icepaule/Ice-Traffic-Data/README.md

# Ice-Traffic-Data

Mobiler Empfang von **C-ITS / ITS-G5 (802.11p)** Verkehrsdaten im Auto – Ampeldaten (SPATEM/MAPEM), Fahrzeugmeldungen (CAM) und Gefahrenmeldungen (DENM) – mit zwei günstigen ESP32-Boards und Anzeige über das iPhone.

> **Status:** Firmware (C5 + C3) und lokaler Decoder bauen/laufen; Decoder mit synthetischen Daten getestet. Hardware (DigiKey) ist bestellt, **echte Funkdaten stehen noch aus**. Auch als Webseite: <https://icepaule.github.io/Ice-Traffic-Data/>. Offene Punkte stehen in [docs/07-offene-punkte.md](docs/07-offene-punkte.md).

## Idee in einem Bild

Diagramm readme-0

<details><summary>Mermaid-Quelltext</summary>

```mermaid
flowchart LR
    RSU["Ampel / RSU<br/>Fahrzeuge / Baustellenwarner"] -- "ITS-G5 5,9 GHz" --> C5["ESP32-C5<br/>Sniffer"]
    C5 -- "UART 921600, ITS6-Format" --> C3["ESP32-C3<br/>WLAN/MQTT-Bruecke"]
    C3 -- "WLAN 2,4 GHz" --> HS["iPhone<br/>Hotspot"]
    HS -- "LTE/5G, MQTT/TLS" --> SRV["Heimserver<br/>Decoder + Dashboard"]
    SRV --> SAF["Safari auf dem iPhone"]
```

</details>

## So sieht das Dashboard aus (Demo-Daten)
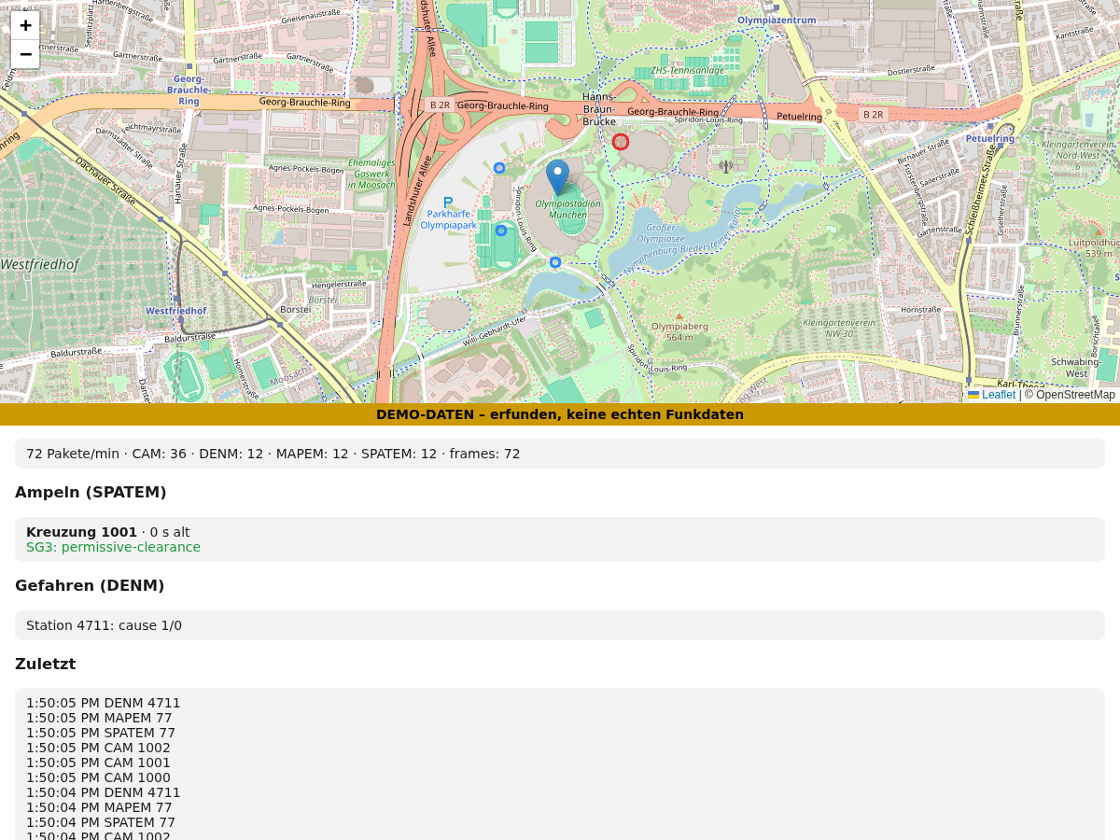
[picture p1: docs/screenshots/dashboard-demo.png]
Dashboard mit erfundenen Demo-Daten


## Anleitung (Schritt für Schritt)

| Schritt | Thema |
|---|---|
| 0 | [Architektur, Setup und Datenfluss (Mermaid)](docs/00-architektur.md) |
| 1 | [Grundlagen: Verkehrsdaten-Techniken & Nachrichtentypen](docs/01-grundlagen.md) |
| 2 | [Hardware & Einkaufsliste](docs/02-hardware.md) |
| 3 | [Verdrahtung](docs/03-verdrahtung.md) |
| 4 | [Firmware bauen & flashen](docs/04-firmware.md) |
| 5 | [iPhone-Hotspot & MQTT](docs/05-iphone-mqtt.md) |
| 6 | [Testfahrt München / Ottobrunn](docs/06-testfahrt.md) |
| 7 | [Offene Punkte & Ausbau](docs/07-offene-punkte.md) |
| 8 | [Anbindung an den Heimserver (DDNS, TLS-MQTT)](docs/08-heimserver.md) |
| 9 | [Lokaler Decoder & Dashboard](docs/09-decoder.md) |
| 10 | [Analyse: LoRa(WAN) vom Auto nach Hause](docs/10-lorawan.md) |
| 11 | [Antennen](docs/11-antennen.md) |
| 12 | [Stückliste & Bestellung DigiKey](docs/12-bestellung.md) |
| 13 | [Dashboard öffentlich (its.mpauli.de, Vorlage THW-Barbeleg)](docs/13-dashboard-veroeffentlichen.md) |
| 14 | [Inbetriebnahme & Vorbereitung ohne Hardware](docs/14-inbetriebnahme.md) |
| 15 | [TEMPUS: Recherche & Unterstützungsangebot (Mail-Entwurf)](docs/15-tempus.md) |
| 16 | [ToDo nach Liefereingang & Zugänge](docs/16-todo-nach-lieferung.md) |
| 17 | [Umsetzungsplan (Phasen 0–9, mit Teilen)](docs/17-umsetzungsplan.md) |
| 18 | [Stand Schreibtischtest, Statusseite & Mitschnitt](docs/18-schreibtischtest-und-mitschnitt.md) |
| 19 | [Gehäuse (3D-Druck, SolidWorks-STEP)](docs/19-gehaeuse.md) |
| 20 | [Auswertung der ersten Testfahrt (echte CAM/DENM, Beifang)](docs/20-auswertung-testfahrt-1.md) |
| 21 | [Testfahrt 1: Empfangs-Timeline, Karte, Verbesserungen](docs/21-testfahrt-1-timeline-karte-verbesserungen.md) |
| 22 | [Plan und Umsetzung Verbesserungen V1–V9](docs/22-plan-verbesserungen.md) |
| 23 | [TEMPUS-Nachfolge, heutige Einsätze, Erweiterungen](docs/23-tempus-nachfolge-und-erweiterungen.md) |
| 24 | [Messfahrt 2: Vorbereitung und Checkliste](docs/24-messfahrt-2-vorbereitung.md) |

## Quellen

- Firmware: <https://github.com/bertrik/its-g5-receiver> (Ordner `esp32-c5-sniffer/`, `esp32-c3-bridge/`)
- Projektbeschreibung des Autors: <https://revspace.nl/Its-g5>
- OpenTrafficMap Wiki: <https://wiki.opentrafficmap.org>
- Alternative (Android): V2X2MAP, CITS-to-go
