icepaule/Ice-Traffic-Data/docs/19-gehaeuse.md

# 19 – Gehäuse (3D-Druck, Entwurf v0.3)

Ein Gehäuse für **alle** Teile: Traffik-Sniffer (C5), Trafik-CPU (C3), GPS-LoRa (XIAO + Wio-SX1262), Grove-GPS und das Prepboard. Konstruiert **parametrisch** mit [CadQuery](https://github.com/CadQuery/cadquery) (`hardware/case/ice_traffic_case.py`). Die STEP-Dateien lassen sich in **SolidWorks** öffnen (Datei → Öffnen → STEP), die STL-Dateien gehen direkt in den Slicer.

> **Status: Entwurf v0.2.** Nur die Länge des Traffik-Sniffers (53,5 mm) ist gemessen. Die übrigen Maße stammen aus Herstellerunterlagen (Espressif-Zeichnung, Seeed-Wiki) oder sind geschätzt (siehe „Maße der Boards"). **Vor dem Druck prüfen** und im Skript oben anpassen.

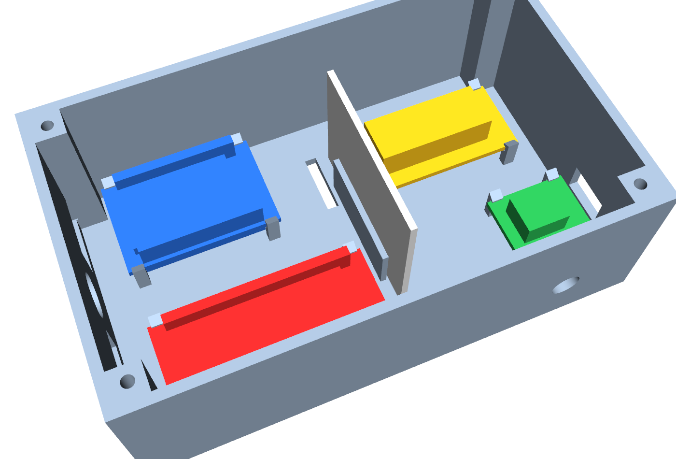
[picture p2: docs/screenshots/gehaeuse-bestueckt.png]
Gehäuse bestückt


*Unterteil mit Platzhalter-Boards: rot = Traffik-Sniffer, blau = Trafik-CPU, grün = GPS-LoRa, gelb = Grove-GPS, grau = Prepboard (hochkant). Die Platzhalter sind nur zur Kollisionsprüfung da, sie sind nicht Teil des Drucks.*

## Änderung v0.3 (09.11.2026, nach dem ersten Einbau)

Beim Einbau passte v0.2 nicht: Stege (Schraubdome) blockierten die Boards, und das hochkant stehende Prepboard in der Mitte stand 4 mm hinter dem Ende von C5 und C3 und damit vor deren WLAN-Antennen. Änderungen:

- **Prepboard-Schlitz entfällt** (Rippen in Unterteil und Deckel); das Prepboard wird innen an den Deckel geklebt. Die Mitte ist frei.
- **C5 und C3 nach innen:** 8 mm statt 2 mm Abstand zur Vorder- bzw. Rückwand (frei von den 7-mm-Domen) und 16 mm statt 8 mm zur linken Wand. Die USB-Schlitze folgen den Boards; die Stecker laufen durch den Wandschlitz in den leeren Innenraum.
- **Strombuchse** (Ø 11 mm) wandert an die **rechte** Stirnwand (Y = 34,4 mm), weil zwischen C5 und C3 nur noch etwa 3 mm bleiben. Das GPS rückt dafür 2 mm nach hinten (Y = 42 mm).
- **Gemessene Gesamtlängen** (inkl. USB und WLAN-Antenne): **C5 60 mm, C3 45 mm**; die Platten sind 53,5 bzw. 38,9 mm lang, der Rest ist Überstand (vermutlich Antenne am Ende gegenüber USB, die Aufteilung ist nicht gemessen). Das Modell führt den Überstand als Platzhalter am +X-Ende. Damit endet der C5 bei X = 76 mm, der C3 bei X = 61 mm.
- **GPS** rückt dafür auf X = 76 mm. **Freiraum hinter den Antennen:** C3 bis GPS 15 mm, C5 bis XIAO 20 mm (Faustwerte, keine Herstellerwerte). Kollisionsrechnung gegen Wände, Dome, Clips, Boards und Strombuchse: keine Kollision.
- Neue **Passprobe `IceTraffic_Passprobe_C5_Ecke`** (42 × 46 × 16 mm): Eckdom, Wände, USB-Schlitz und Clips des C5 in der neuen Lage. Mit der **echten Platine** prüfen, bevor das ganze Gehäuse gedruckt wird.

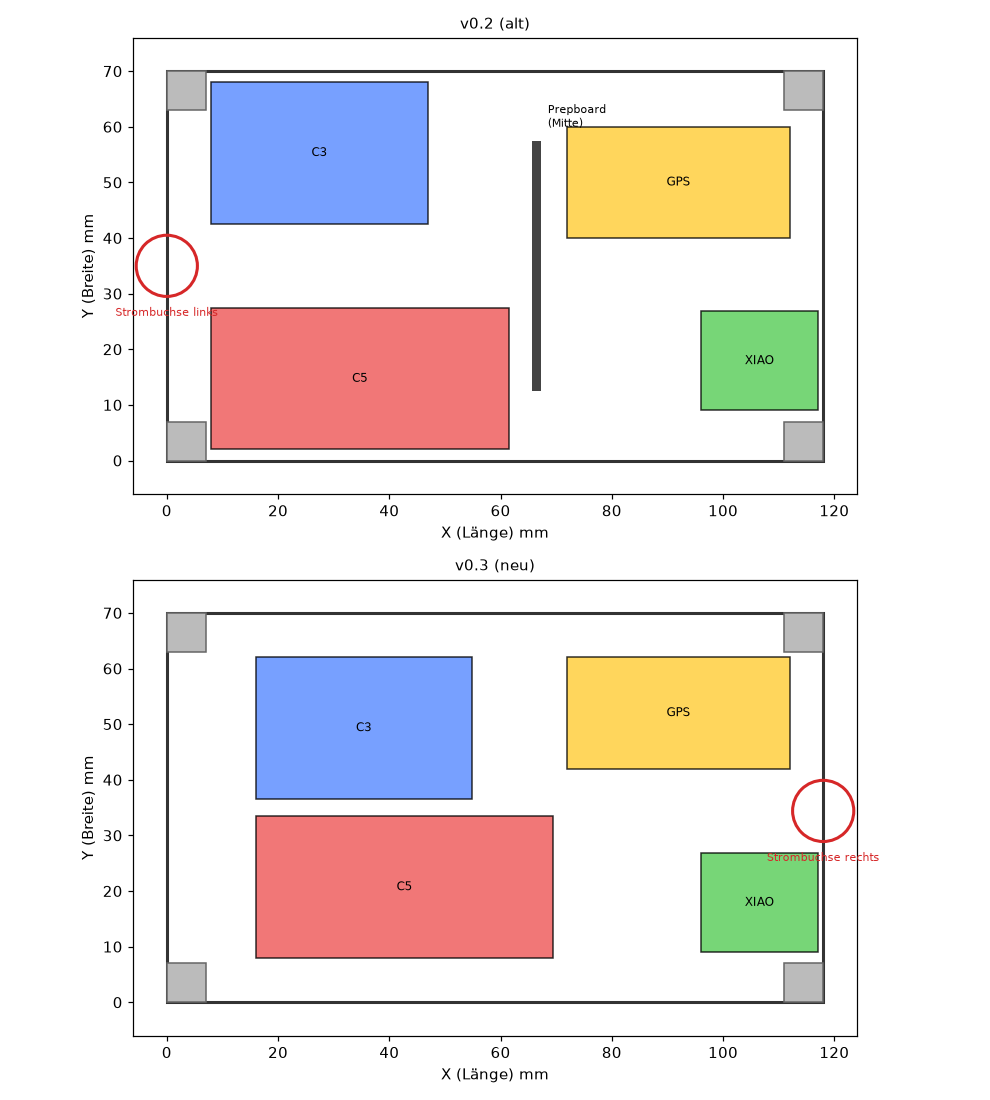
[picture p3: docs/screenshots/gehaeuse-v03-draufsicht.png]
Draufsicht alt und neu


**Grenze der Prüfung:** Die Kollisionsrechnung im CAD-Modell findet für v0.2 und v0.3 keine Kollision, weil das Modell nur die angenommenen Boardmaße kennt. Sie reproduziert also das, was beim Einbau passiert ist, nicht. Die echten Maße von C5 und C3 (Breite mit Stiftleisten, Lage der Antenne) sind weiter nicht gemessen; die Passprobe mit der echten Platine ist die eigentliche Prüfung. Die älteren Bilder weiter unten zeigen noch v0.2.

## Maße und Bohrungen

| Merkmal | Wert |
|---|---|
| Außenmaß (Unterteil) | 122,8 × 74,8 × 40,4 mm (Innenraum 118 × 70 × 38 mm) |
| Wand / Boden | 2,4 mm |
| **Antenne** | **Ø 7 mm**, Frontwand, Höhe 12 mm, nahe dem GPS-LoRa |
| **Stromanschluss** | **Ø 11 mm**, **rechte** Stirnwand (v0.3), Y = 34,4 mm zwischen XIAO und GPS, Höhe 16 mm |
| USB-Zugang | ein Schlitz 24 × 10 mm für C5 (2 × USB-C) und 16 × 10 mm für C3 (Micro-USB), linke Wand, ein Schlitz 12 × 8 mm für das GPS-LoRa (rechte Wand; das GPS-LoRa sitzt direkt an dieser Wand) – Flashen ohne Öffnen |
| Deckel | 4 × M3 in Eckdomen (Kernloch 2,8 mm für selbstschneidende Schrauben), Senkung für Linsenkopf, 8 Lüftungsschlitze, Stützlippe |
| Boden | je 4 Schlitze (3 × 16 mm) für Kabelbinder oder Klett zur Befestigung im Auto |

## Aufnahme der Platinen (Clips)

Jede Platine liegt auf vier Auflagen und wird von vier **Schnappclips** in den Ecken gehalten: Auflage 0,8 mm unter der Platine, Haken 0,7 mm über der Platine (oben angeschrägt). Platine **schräg einsetzen** und eindrücken, der dünne Steg (1,2 mm) gibt nach. Zwischen Boden und Platinenunterseite bleiben **5 mm** für die Stiftleisten. Die Clips sitzen in den Ecken, damit sie die Stiftleisten (ab etwa 1 mm Randabstand) nicht berühren.

Das **Prepboard (35 × 45 mm)** hat seit v0.3 keinen Schlitz mehr, es wird innen an den Deckel geklebt (v0.2: hochkant in der Mitte).

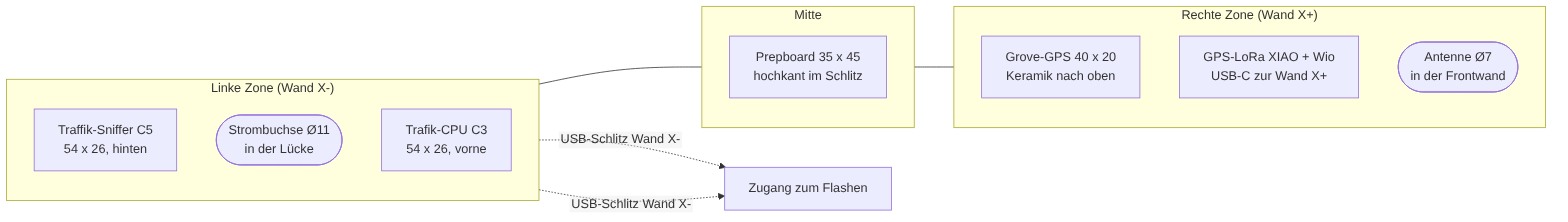
[picture p4: docs/diagrams/19-gehaeuse-layout-0.png]
Anordnung


<details><summary>Mermaid-Quelltext</summary>

```mermaid
flowchart LR
    subgraph LINKS["Linke Zone (Wand X-)"]
        direction TB
        C5["Traffik-Sniffer C5<br/>54 x 26, hinten"]
        PWR(["Strombuchse Ø11<br/>in der Lücke"])
        C3["Trafik-CPU C3<br/>54 x 26, vorne"]
    end
    subgraph MITTE["Mitte"]
        PREP["Prepboard 35 x 45<br/>hochkant im Schlitz"]
    end
    subgraph RECHTS["Rechte Zone (Wand X+)"]
        direction TB
        GPS["Grove-GPS 40 x 20<br/>Keramik nach oben"]
        XIAO["GPS-LoRa XIAO + Wio<br/>USB-C zur Wand X+"]
        ANT(["Antenne Ø7<br/>in der Frontwand"])
    end
    LINKS --- MITTE --- RECHTS
    C5 -. "USB-Schlitz Wand X-" .-> W1["Zugang zum Flashen"]
    C3 -. "USB-Schlitz Wand X-" .-> W1
```

</details>

## Ansichten

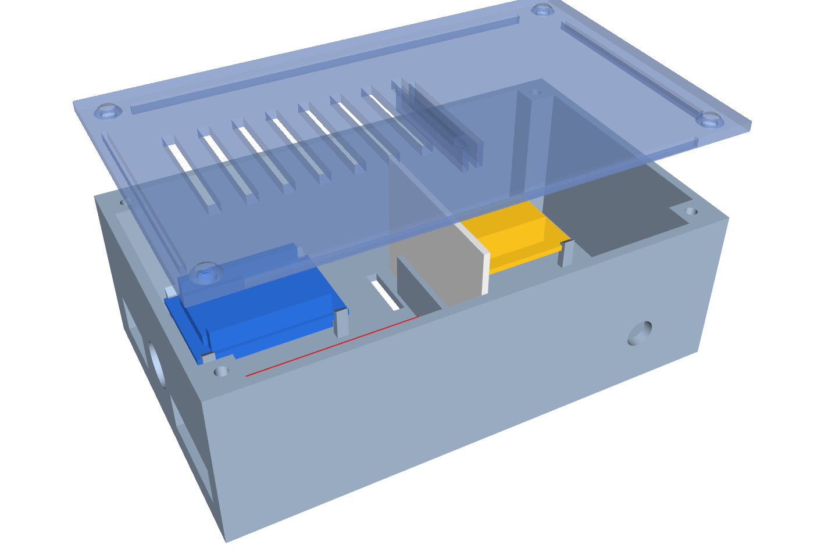
[picture p5: docs/screenshots/gehaeuse-explosion.png]
Explosion


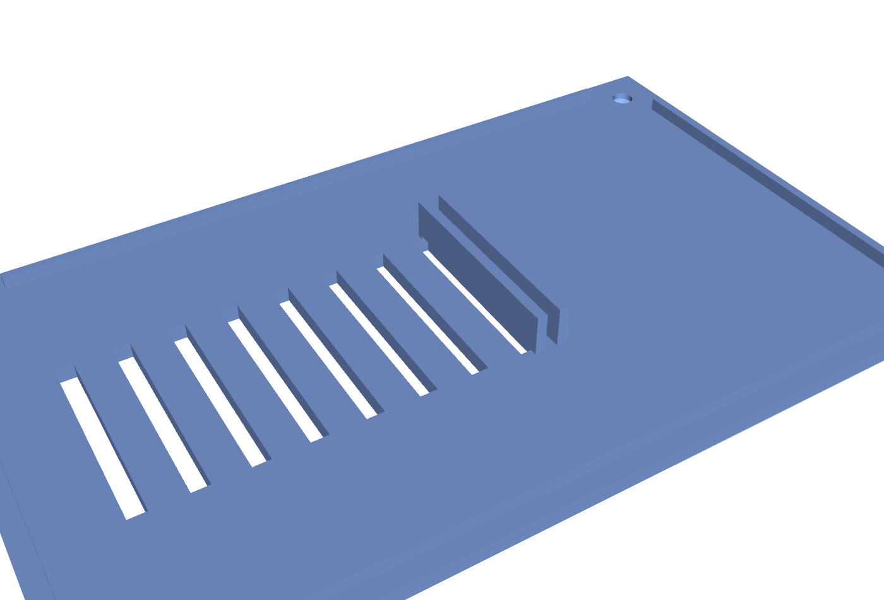
[picture p6: docs/screenshots/gehaeuse-deckel.png]
Deckel


## Dateien

| Datei | Zweck |
|---|---|
| `hardware/case/ice_traffic_case.py` | parametrisches Skript (Maße oben im Kopf) |
| `hardware/case/cad/IceTraffic_Gehaeuse_Unterteil.step` / `.stl` | Unterteil |
| `hardware/case/cad/IceTraffic_Gehaeuse_Deckel.step` / `.stl` | Deckel, **in Druckrichtung** (Platte unten) |
| `hardware/case/cad/IceTraffic_Montage_mit_Boards.step` | Zusammenbau mit Platzhalter-Boards, Deckel in Einbaulage (für SolidWorks-Passprüfung) |

Neu erzeugen: `pip install cadquery && python3 hardware/case/ice_traffic_case.py hardware/case/cad`

## Druck auf dem Anycubic Kobra S1

| Einstellung | Empfehlung |
|---|---|
| Werkstoff | **PETG** oder **ASA**, kein PLA (im Auto über 55 °C weich, Sonne hinter der Scheibe reicht) |
| Schicht / Wand | 0,2 mm, 3 Wände, 25 % Füllung |
| Ausrichtung | Unterteil mit der Öffnung nach oben, Deckel mit der Platte unten (so liegt die STL) |
| Stützen | keine nötig (Antennen- und USB-Öffnungen werden überbrückt, Haken sind 45°-Schrägen); bei Problemen Stützen nur für die Öffnungen in den Wänden |
| Passprobe | zuerst nur den Bereich mit einem Clip drucken (ca. 20 min) und eine Platine einsetzen |

Bauraum: das Unterteil (123 × 79 mm) passt bequem auf das Druckbett.

## Passprobe (vor dem großen Druck)

`IceTraffic_Passprobe.stl` / `.step` (64 × 54 × 16 mm, rund 20 Minuten Druck) enthält die kritischen Stellen auf einer Platte:
- das **Ende des Traffik-Sniffers** mit zwei Clips (Platine nur auflegen und eindrücken),
- den **kompletten GPS-LoRa-Stapel** mit vier Clips,
- den **Prepboard-Schlitz** (Platine hochkant einschieben, soll mit leichtem Klemmen halten),
- eine Rückwand mit der **Antennenbohrung Ø 7** und der **Strombohrung Ø 11** (Buchse und SMA-Stecker probehalber einsetzen).

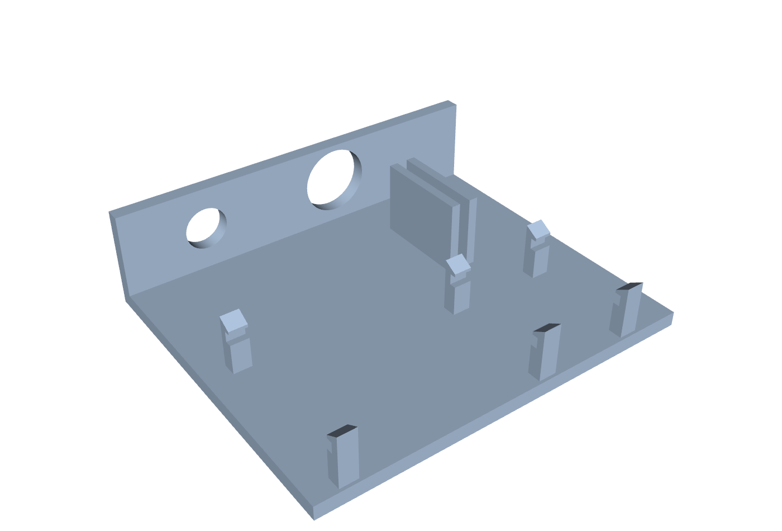
[picture p7: docs/screenshots/gehaeuse-passprobe.png]
Passprobe


Prüfen: Rastet die Platine hörbar ein, ohne dass ein Clip bricht? Sitzt sie ohne Spiel? Passt die Buchse in Ø 11? Wenn ein Clip zu stramm oder zu locker ist, `TOL`, `LEDGE` und `HOOK` im Skript anpassen.

## Maße der Boards (Stand v0.2)

| Board | Maß im Modell | Quelle |
|---|---|---|
| Traffik-Sniffer (ESP32-C5-DevKitC-1) | **53,5 × 25,4 mm** Platte, **60 mm Gesamtlänge** inkl. USB und WLAN | Platte: Länge gemessen, Breite Espressif (25,4); Gesamtlänge gemessen (09.11.2026) |
| Trafik-CPU (ESP32-C3-DevKitM-1) | **38,9 × 25,4 mm** Platte, **45 mm Gesamtlänge** inkl. USB und WLAN | [Espressif-Maßzeichnung (DXF)](https://dl.espressif.com/dl/schematics/DIMENSION_ESP32-C3-DEVKITM-1_V1_20200915AA.dxf): 25,40 × 38,91; Stiftreihen etwa 22,86 mm auseinander, 1,27 mm vom Rand |
| GPS-LoRa (XIAO ESP32S3 auf Wio-SX1262, B2B-Stapel) | **21 × 17,8 mm**, Höhe geschätzt (ca. 6 mm Bauteile) | [Seeed-Wiki](https://wiki.seeedstudio.com/wio_sx1262_with_xiao_esp32s3_kit/) (21 × 17,8); Stapelhöhe und Lage von USB-C und U.FL **nicht angegeben** |
| Grove-GPS Air530 | **40 × 20 mm**, Höhe bis 13 mm | Händlerangaben, kein Herstellermaß |
| Prepboard | 45 × 35 mm, 1,6 mm dick | Vorgabe |

Die früheren Annahmen (C3 54 mm, XIAO-Stapel 42 × 25 mm) waren falsch und sind korrigiert; dadurch ist das Gehäuse kleiner geworden.

## Noch zu prüfen (Annahmen im Skript)

| Maß | Annahme | Warum wichtig |
|---|---|---|
| Abstand Stiftleiste – Platinenrand und -ende (C5) | ≥ 1 mm | Haken darf nicht auf der Leiste sitzen |
| Lage der USB-Buchsen von C5 und C3 | beide an der linken kurzen Seite | Lage der Schlitze |
| GPS-LoRa: Seite von USB-C und U.FL | USB-C zur rechten Wand, U.FL nach vorn | Schlitz und Antennenbohrung |
| Höhe des GPS-LoRa-Stapels | 6 mm über der Platine | Abstand zum Deckel (unkritisch) |
| Stromanschluss | Einbaubuchse für Ø 11 mm | Einbautiefe bis ca. 14 mm |

Passen die Maße nicht, ändere `C5`, `C3`, `XIAO`, `GPS` am Skriptanfang und erzeuge neu.

## Offene Punkte
- Prepboard-Verdrahtung zu den Buchsen (Strombuchse → 5-V-Schiene) ist im Modell nicht dargestellt.
- Optionaler Halter für Akku/Powerbank außerhalb des Gehäuses.
- GPS-Empfang unter dem Deckel (2,4 mm PETG) vorab testen; sonst Deckelausschnitt über der Keramikantenne.

## v0.3c – Clips federnd, Boards an der USB-Wand
Rückmeldung nach dem ersten Druck von v0.3b: Die Clips (Platinenhalter) waren zu dick, rasteten nicht ein und brachen ab; C5 und C3 müssen ganz an die USB-Öffnung.

- **Boards an der USB-Wand:** `X_LEFT` 16 → 1,5 mm. Der USB-Stecker reicht in den Wandschlitz. Die Antennenseite liegt dadurch bei etwa 61 mm (C5) bzw. 46 mm (C3), das GPS bleibt bei X = 76 mm.
- **Clipfeder:** Armdicke 1,2 → 0,9 mm an der Spitze, am Fuß 1,6 mm (konisch gegen Bruch am Ansatz). Haken 0,7 → 0,5 mm, längere Einführschräge. Die Biegung bei 0,5 mm Auslenkung bleibt damit im elastischen Bereich von PETG (Überschlag, nicht gemessen).
- **Clips weg vom Eckdom:** Die Clips von C5/C3 sitzen jetzt 9 mm vom Platinenende, weil die Federn vorher an den Schraubdom grenzten und dort angewachsen waren. Federn und Doms berühren sich nicht mehr (Volumenprüfung 0).
- **Druckhinweis:** Das Unterteil so drucken, dass die Clipfedern **quer zur Schichtrichtung nicht auf Zug** beansprucht werden, also möglichst mit den Federn in der Druckebene liegend (Unterteil auf die Seite) oder Passprobe zuerst. Ungeprüft: Das Spiel von 0,3 mm.
- Die Clips zwischen C5 und C3 lassen 0,6 mm Luft zueinander (Mittelspalt 3,2 mm); beim Einsetzen die Boards nacheinander einsetzen.

## v0.3d – Stege 1 mm höher
Passprobe: Die USB-Anschlüsse lagen knapp unter der Unterkante der USB-Schlitze. `POST_H` 5 → 6 mm (Stege/Clips 1 mm länger), die Schlitze bleiben absolut auf alter Höhe; die Boards sitzen damit 1 mm höher relativ zum Schlitz. Nicht geprüft: Innenhöhe über den Bauteilen (H = 38 mm unverändert) und ob 1 mm genau reicht.
