icepaule/Ice-Traffic-Data/docs/00-architektur.md

# 0 – Architektur, Setup und Datenfluss

## Setup im Auto (Hardware)
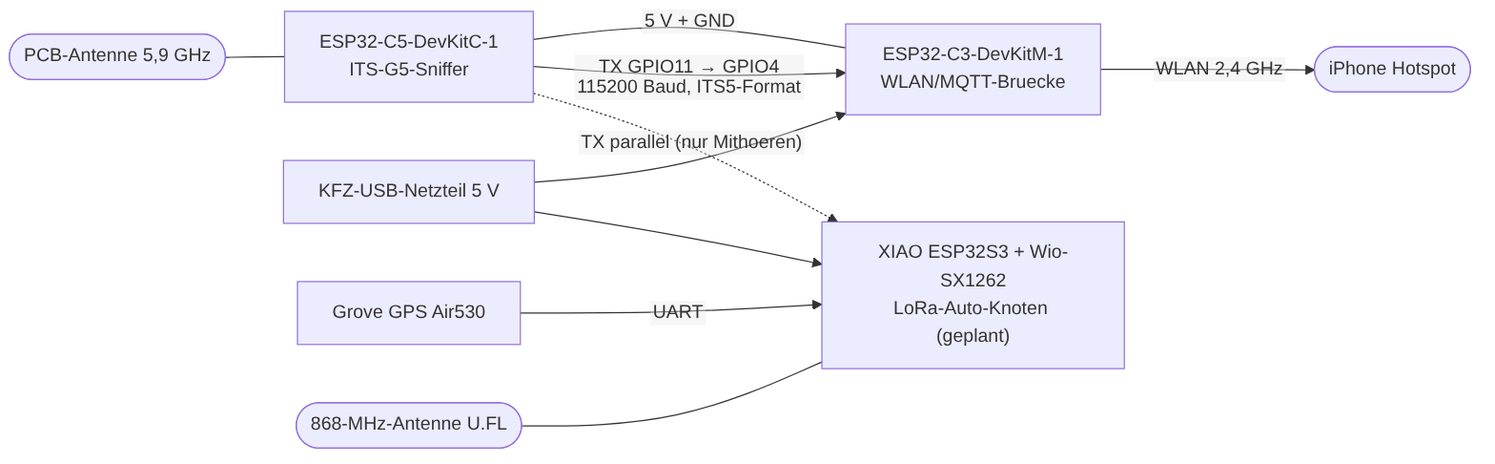
[picture p17: docs/diagrams/00-architektur-0.png]
Diagramm 00-architektur-0


<details><summary>Mermaid-Quelltext</summary>

```mermaid
flowchart LR
    ANT_G5(["PCB-Antenne 5,9 GHz"]) --- C5
    PS["KFZ-USB-Netzteil 5 V"] --> C3
    C5["ESP32-C5-DevKitC-1<br/>ITS-G5-Sniffer"] -- "5 V + GND" --- C3["ESP32-C3-DevKitM-1<br/>WLAN/MQTT-Bruecke"]
    C5 -- "TX GPIO11 → GPIO4<br/>115200 Baud, ITS5-Format" --> C3
    C5 -. "TX parallel (nur Mithoeren)" .-> S3["XIAO ESP32S3 + Wio-SX1262<br/>LoRa-Auto-Knoten (geplant)"]
    GPS["Grove GPS Air530"] -- UART --> S3
    ANT_L(["868-MHz-Antenne U.FL"]) --- S3
    PS --> S3
    C3 -- "WLAN 2,4 GHz" --> HS(["iPhone Hotspot"])
```

</details>

## Systemübersicht (Auto → Heimnetz → Anzeige)
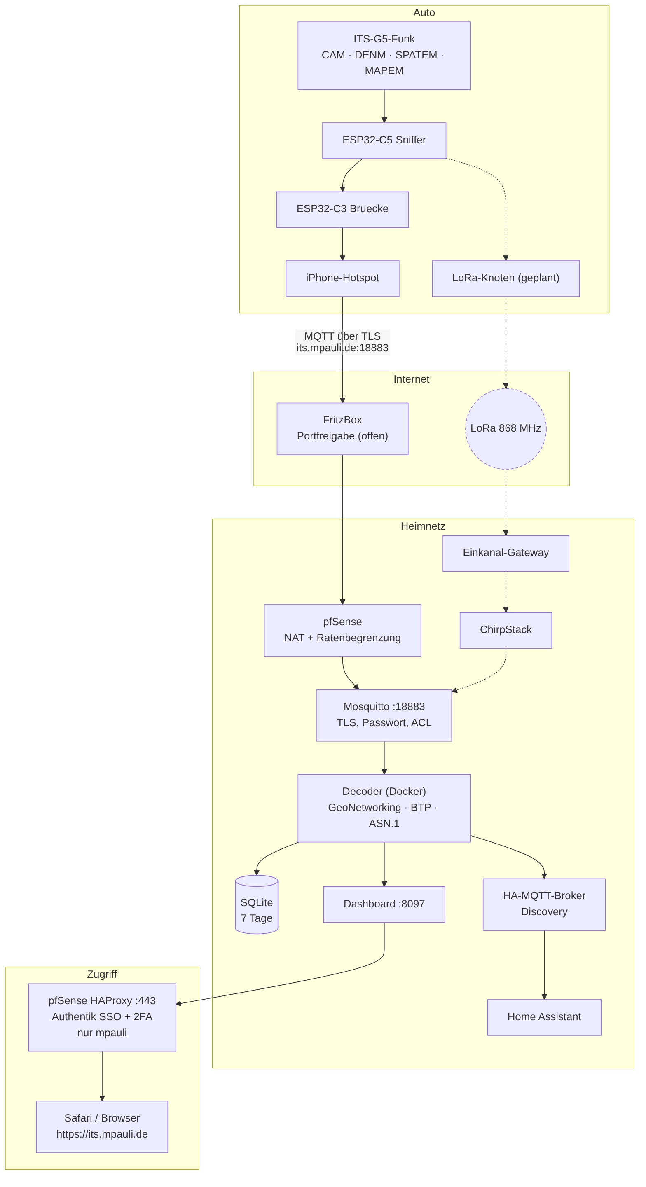
[picture p18: docs/diagrams/00-architektur-1.png]
Diagramm 00-architektur-1


<details><summary>Mermaid-Quelltext</summary>

```mermaid
flowchart TB
    subgraph Auto
      RF["ITS-G5-Funk<br/>CAM · DENM · SPATEM · MAPEM"] --> C5["ESP32-C5 Sniffer"]
      C5 --> C3["ESP32-C3 Bruecke"]
      C5 -.-> S3["LoRa-Knoten (geplant)"]
      C3 --> HS["iPhone-Hotspot"]
    end
    subgraph Internet
      HS -- "MQTT über TLS<br/>its.mpauli.de:18883" --> FB["FritzBox<br/>Portfreigabe (offen)"]
      LORA(("LoRa 868 MHz")):::dash
    end
    S3 -.-> LORA
    subgraph Heimnetz
      FB --> PF["pfSense<br/>NAT + Ratenbegrenzung"]
      PF --> MQ["Mosquitto :18883<br/>TLS, Passwort, ACL"]
      LORA -.-> GW["Einkanal-Gateway"] -.-> CS["ChirpStack"] -.-> MQ
      MQ --> DEC["Decoder (Docker)<br/>GeoNetworking · BTP · ASN.1"]
      DEC --> DB[("SQLite<br/>7 Tage")]
      DEC --> DASH["Dashboard :8097"]
      DEC --> HAMQ["HA-MQTT-Broker<br/>Discovery"] --> HA["Home Assistant"]
    end
    subgraph Zugriff
      DASH --> HP["pfSense HAProxy :443<br/>Authentik SSO + 2FA<br/>nur mpauli"] --> SAF["Safari / Browser<br/>https://its.mpauli.de"]
    end
    classDef dash stroke-dasharray: 4 3;
```

</details>

Gestrichelt = geplant bzw. noch nicht gebaut oder nicht freigeschaltet.

## Datenfluss eines Pakets
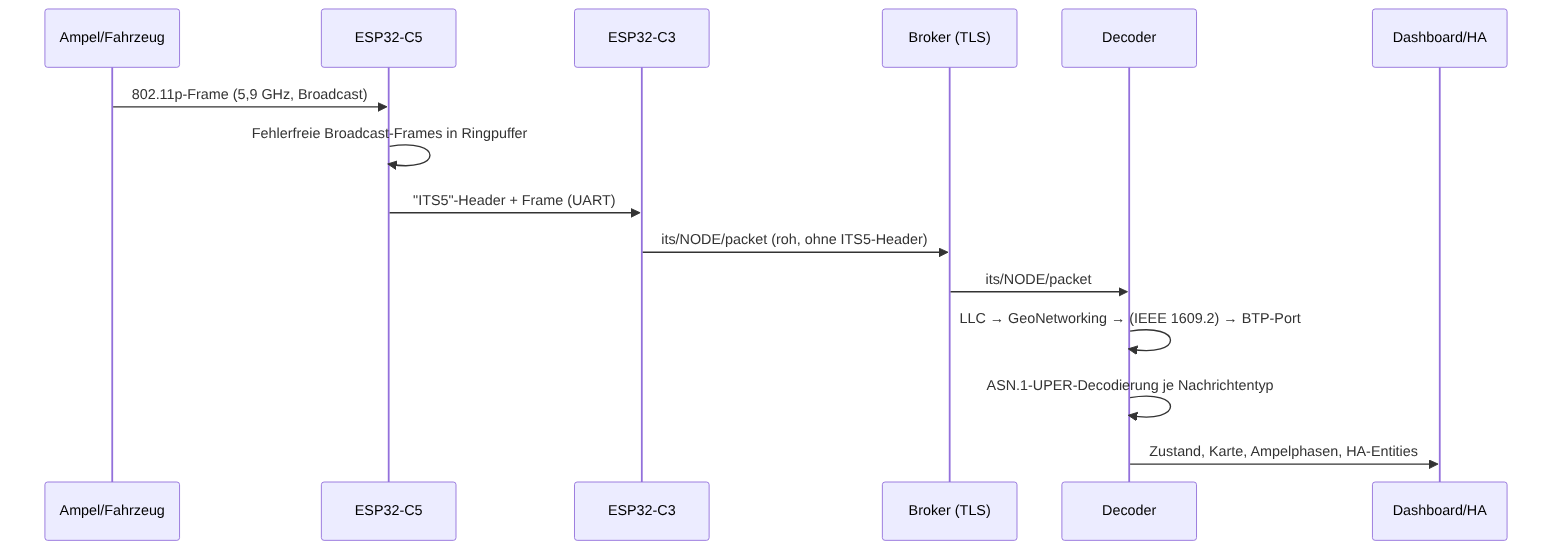
[picture p19: docs/diagrams/00-architektur-2.png]
Diagramm 00-architektur-2


<details><summary>Mermaid-Quelltext</summary>

```mermaid
sequenceDiagram
    participant V as Ampel/Fahrzeug
    participant C5 as ESP32-C5
    participant C3 as ESP32-C3
    participant B as Broker (TLS)
    participant D as Decoder
    participant W as Dashboard/HA
    V->>C5: 802.11p-Frame (5,9 GHz, Broadcast)
    C5->>C5: Fehlerfreie Broadcast-Frames in Ringpuffer
    C5->>C3: "ITS5"-Header + Frame (UART)
    C3->>B: its/NODE/packet (roh, ohne ITS5-Header)
    B->>D: its/NODE/packet
    D->>D: LLC → GeoNetworking → (IEEE 1609.2) → BTP-Port
    D->>D: ASN.1-UPER-Decodierung je Nachrichtentyp
    D->>W: Zustand, Karte, Ampelphasen, HA-Entities
```

</details>

## Dekodier-Pipeline (Detail)
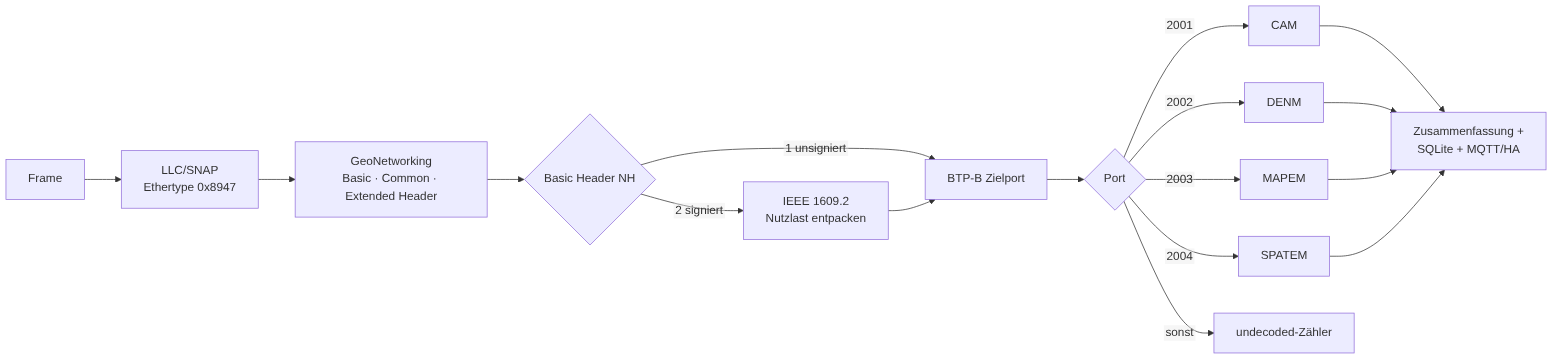
[picture p20: docs/diagrams/00-architektur-3.png]
Diagramm 00-architektur-3


<details><summary>Mermaid-Quelltext</summary>

```mermaid
flowchart LR
    F["Frame"] --> L["LLC/SNAP<br/>Ethertype 0x8947"]
    L --> G["GeoNetworking<br/>Basic · Common · Extended Header"]
    G --> S{"Basic Header NH"}
    S -- "1 unsigniert" --> BTP
    S -- "2 signiert" --> E["IEEE 1609.2<br/>Nutzlast entpacken"] --> BTP
    BTP["BTP-B Zielport"] --> T{"Port"}
    T -- 2001 --> CAM
    T -- 2002 --> DENM
    T -- 2003 --> MAPEM
    T -- 2004 --> SPATEM
    T -- "sonst" --> U["undecoded-Zähler"]
    CAM --> OUT["Zusammenfassung +<br/>SQLite + MQTT/HA"]
    DENM --> OUT
    MAPEM --> OUT
    SPATEM --> OUT
```

</details>

## Sicherheitsschichten
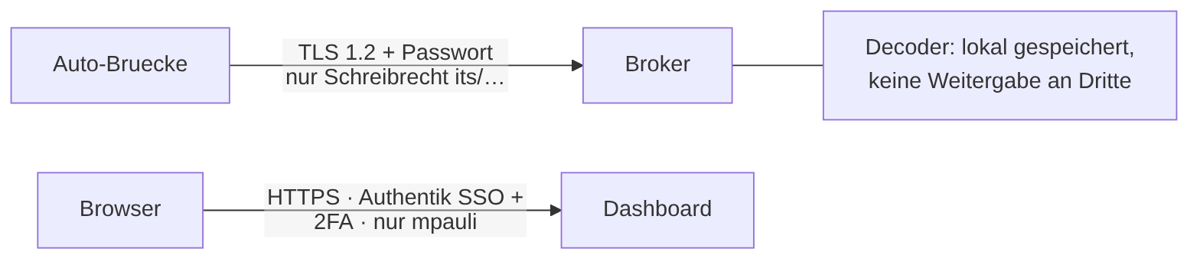
[picture p21: docs/diagrams/00-architektur-4.png]
Diagramm 00-architektur-4


<details><summary>Mermaid-Quelltext</summary>

```mermaid
flowchart LR
    A["Auto-Bruecke"] -- "TLS 1.2 + Passwort<br/>nur Schreibrecht its/…" --> B["Broker"]
    C["Browser"] -- "HTTPS · Authentik SSO + 2FA · nur mpauli" --> D["Dashboard"]
    B --- E["Decoder: lokal gespeichert,<br/>keine Weitergabe an Dritte"]
```

</details>

## LoRa-Anbindung (Zusatzkanal)
Der LoRa-Auto-Knoten schickt nur **Zusammenfassungen** (Zähler je Nachrichtentyp, Position, Funkqualität) – die vollen Daten kommen weiter über das Handy. Details und Einordnung: [10](10-lorawan.md).

### Verbindungen
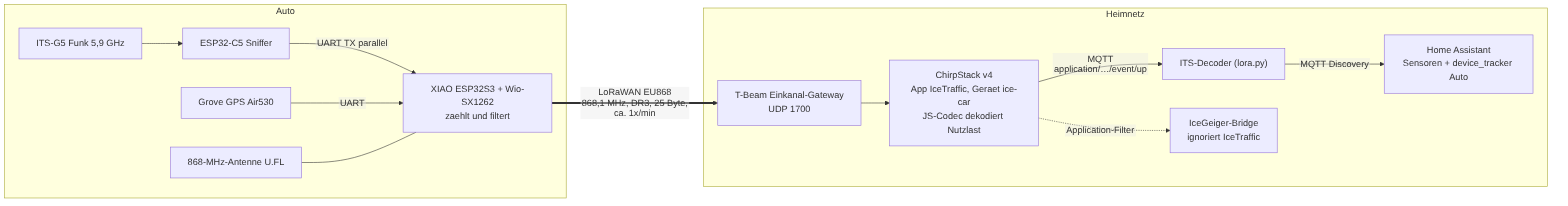
[picture p22: docs/diagrams/00-lora-0.png]
LoRa-Anbindung


<details><summary>Mermaid-Quelltext</summary>

```mermaid
flowchart LR
    subgraph Auto
      RF["ITS-G5 Funk 5,9 GHz"] --> C5["ESP32-C5 Sniffer"]
      C5 -- "UART TX parallel" --> S3["XIAO ESP32S3 + Wio-SX1262<br/>zaehlt und filtert"]
      GPS["Grove GPS Air530"] -- UART --> S3
      ANT["868-MHz-Antenne U.FL"] --- S3
    end
    S3 == "LoRaWAN EU868<br/>868,1 MHz, DR3, 25 Byte, ca. 1x/min" ==> GW
    subgraph Heimnetz
      GW["T-Beam Einkanal-Gateway<br/>UDP 1700"] --> CS["ChirpStack v4<br/>App IceTraffic, Geraet ice-car<br/>JS-Codec dekodiert Nutzlast"]
      CS -- "MQTT application/…/event/up" --> DEC["ITS-Decoder (lora.py)"]
      DEC -- "MQTT Discovery" --> HA["Home Assistant<br/>Sensoren + device_tracker Auto"]
      CS -. "Application-Filter" .-> IG["IceGeiger-Bridge<br/>ignoriert IceTraffic"]
    end
```

</details>

### Datenfluss eines LoRa-Uplinks
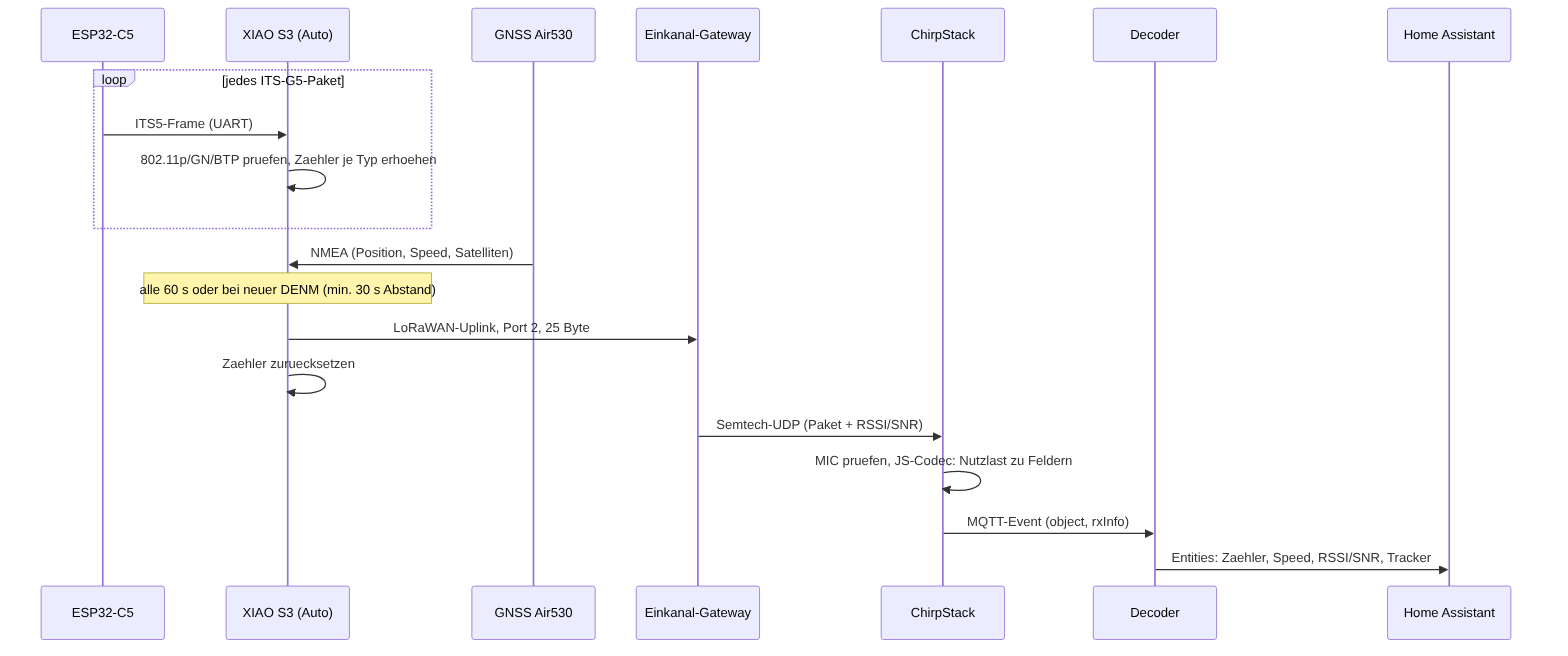
[picture p23: docs/diagrams/00-lora-1.png]
LoRa-Datenfluss


<details><summary>Mermaid-Quelltext</summary>

```mermaid
sequenceDiagram
    participant C5 as ESP32-C5
    participant S3 as XIAO S3 (Auto)
    participant G as GNSS Air530
    participant GW as Einkanal-Gateway
    participant CS as ChirpStack
    participant D as Decoder
    participant HA as Home Assistant
    loop jedes ITS-G5-Paket
        C5->>S3: ITS5-Frame (UART)
        S3->>S3: 802.11p/GN/BTP pruefen, Zaehler je Typ erhoehen
    end
    G->>S3: NMEA (Position, Speed, Satelliten)
    Note over S3: alle 60 s oder bei neuer DENM (min. 30 s Abstand)
    S3->>GW: LoRaWAN-Uplink, Port 2, 25 Byte
    S3->>S3: Zaehler zuruecksetzen
    GW->>CS: Semtech-UDP (Paket + RSSI/SNR)
    CS->>CS: MIC pruefen, JS-Codec: Nutzlast zu Feldern
    CS->>D: MQTT-Event (object, rxInfo)
    D->>HA: Entities: Zaehler, Speed, RSSI/SNR, Tracker
```

</details>

### Beide Wege im Vergleich
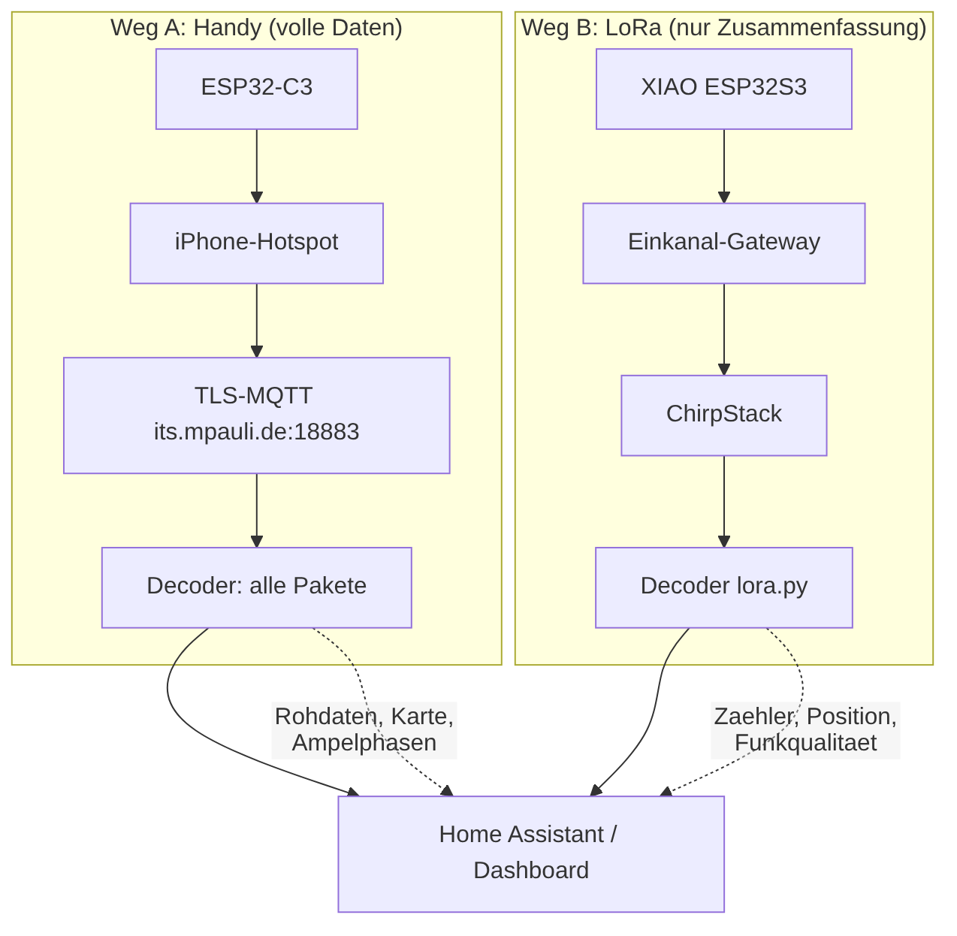
[picture p24: docs/diagrams/00-lora-2.png]
Handy-Weg und LoRa-Weg


<details><summary>Mermaid-Quelltext</summary>

```mermaid
flowchart TB
    subgraph W["Weg A: Handy (volle Daten)"]
      A1["ESP32-C3"] --> A2["iPhone-Hotspot"] --> A3["TLS-MQTT its.mpauli.de:18883"] --> A4["Decoder: alle Pakete"]
    end
    subgraph L["Weg B: LoRa (nur Zusammenfassung)"]
      B1["XIAO ESP32S3"] --> B2["Einkanal-Gateway"] --> B3["ChirpStack"] --> B4["Decoder lora.py"]
    end
    A4 --> HA["Home Assistant / Dashboard"]
    B4 --> HA
    A4 -. "Rohdaten, Karte, Ampelphasen" .-> HA
    B4 -. "Zaehler, Position, Funkqualitaet" .-> HA
```

</details>
