icepaule/Ice-Traffic-Data/docs/07-offene-punkte.md

# 7 – Offene Punkte & Ausbau

- [ ] Boards treffen ein → Pin-Check (C5 TX = GPIO11?), Firmware flashen, Schreibtischtest
- [ ] Decoder mit **echten** Paketen validieren (signierte Pakete, Versionen) – [09](09-decoder.md)
- [ ] Gibt es SPATEM/MAPEM über ITS-G5 in München/Ottobrunn? (Messfahrt)
- [ ] Antenne: erst Platine testen, dann ggf. U.FL-Board – [11](11-antennen.md)
- [ ] LoRa-Auto-Knoten: Firmware-Entwurf steht, auf Hardware testen – [10](10-lorawan.md), [14](14-inbetriebnahme.md)
- [ ] TEMPUS kontaktieren (Mail-Entwurf fertig, noch nicht versendet) – [15](15-tempus.md)
- [ ] UART 115200 Baud begrenzt (~11,5 kB/s): höhere Baudrate, Drop-Zähler beobachten
- [ ] Eigene Position für „Fahrzeug vor/hinter mir" (C5 hat kein GNSS): iPhone-Position oder GNSS am Auto-Knoten
- [ ] Optional: Live-Ampelanzeige direkt auf dem C3 oder ESP32-S3-Touchdisplay (Dekodierung dann im Gerät)
