icepaule/Ice-Traffic-Data/docs/screenshots/gehaeuse-unterteil.png

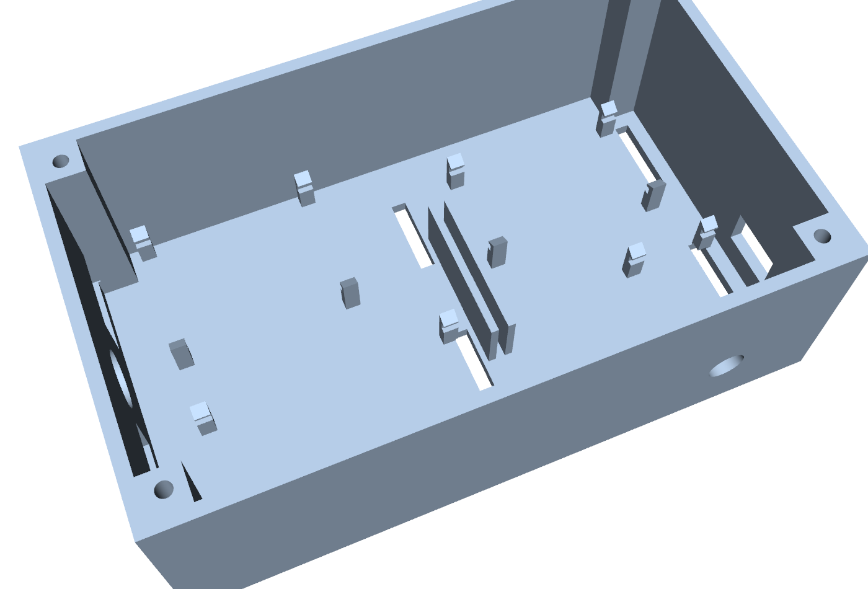
docs/screenshots/gehaeuse-unterteil.png
