icepaule/Ice-Traffic-Data/hardware/case/cad/IceTraffic_Passprobe.step

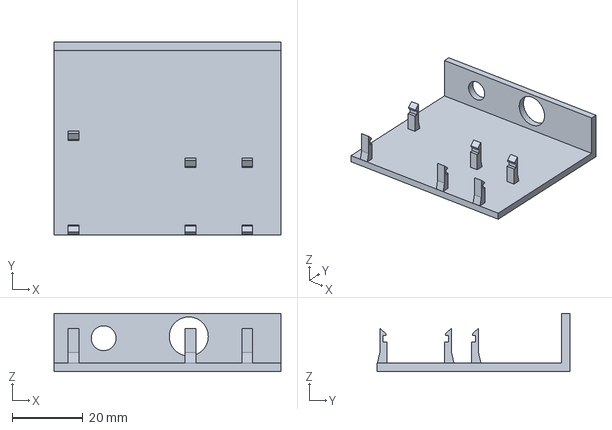
[picture p29: CAD file, 2026-11-09]
hardware/case/cad/IceTraffic_Passprobe.step
64.0 x 54.4 x 16.4 mm
