icepaule/Ice-Traffic-Data/hardware/case/cad/IceTraffic_Passprobe_C5_Ecke.step

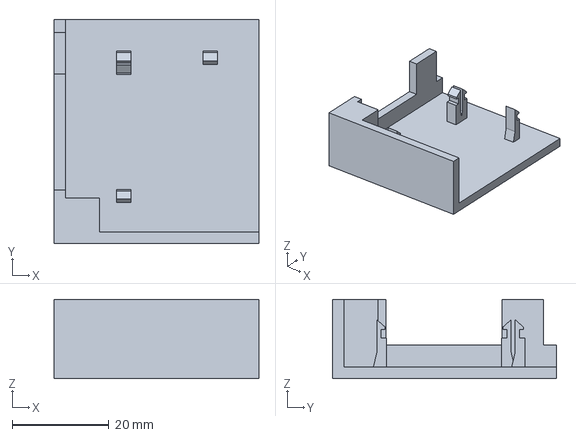
[picture p30: CAD file, 2026-11-09]
hardware/case/cad/IceTraffic_Passprobe_C5_Ecke.step
42.4 x 46.4 x 16.4 mm
