icepaule/Ice-Traffic-Data/hardware/case/cad/IceTraffic_Gehaeuse_Unterteil.step

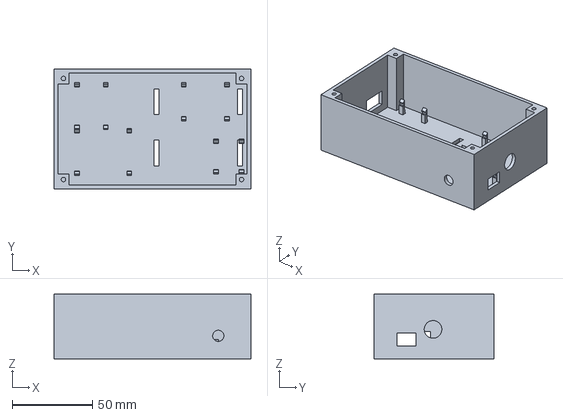
[picture p31: CAD file, 2026-11-09]
hardware/case/cad/IceTraffic_Gehaeuse_Unterteil.step
122.8 x 74.8 x 40.4 mm
