icepaule/Ice-Traffic-Data/hardware/case/cad/IceTraffic_Montage_mit_Boards.step

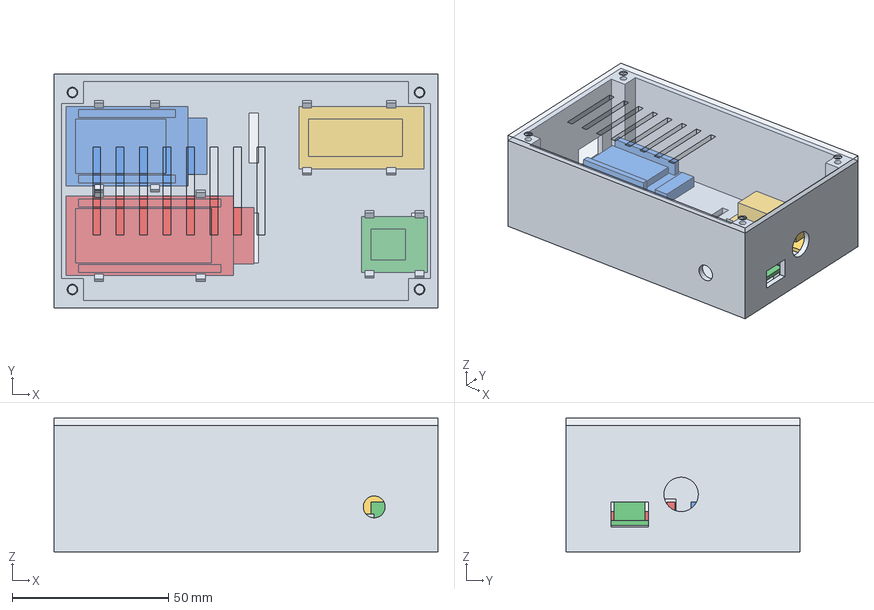
[picture p32: CAD file, 2026-11-09]
hardware/case/cad/IceTraffic_Montage_mit_Boards.step
122.8 x 74.8 x 42.8 mm
Unterteil
Deckel
Traffik-Sniffer_C5
Trafik-CPU_C3
GPS-LoRa_XIAO
Grove-GPS
