icepaule/Ice-Traffic-Data/hardware/case/cad/IceTraffic_Gehaeuse_Deckel.step

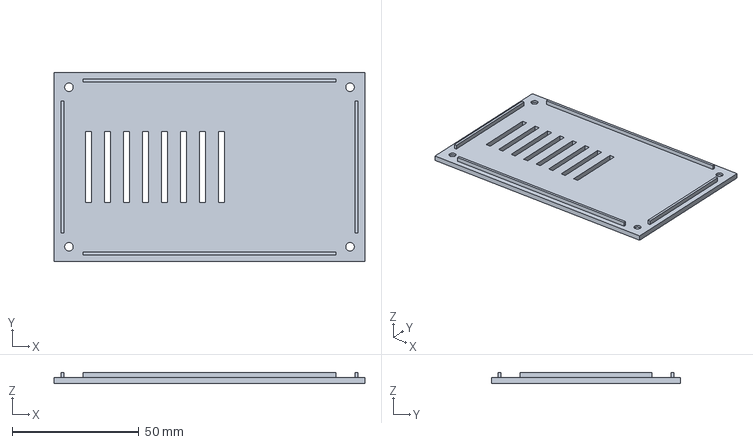
[picture p33: CAD file, 2026-11-09]
hardware/case/cad/IceTraffic_Gehaeuse_Deckel.step
122.8 x 74.8 x 4.40 mm
