icepaule/Ice-Traffic-Data/(list of files, cad)

Other CAD files:
hardware/case/cad/IceTraffic_Gehaeuse_Deckel.stl
hardware/case/cad/IceTraffic_Gehaeuse_Unterteil.stl
hardware/case/cad/IceTraffic_Passprobe.stl
hardware/case/cad/IceTraffic_Passprobe_C5_Ecke.stl
