icepaule/Ice-Traffic-Data/ergebnisse/testfahrt-1/empfang_abschnitte.csv

von_utc | bis_utc | dauer_s | fenster | pakete | davon_sonstige | gespeichert_cam | gespeichert_denm | kmh_median | strassen | ortsteil | ort
2026-11-08T15:26:50Z | 2026-11-08T15:27:43Z | 63 | 6 | 106 | 0 | 23 | 1 | 34 | Innsbrucker Ring > Grafinger Straße | Berg am Laim | München
2026-11-08T15:32:28Z | 2026-11-08T15:32:38Z | 20 | 2 | 21 | 0 | 4 | 0 | 57 | Isarring | Schwabing | München
2026-11-08T15:34:01Z | 2026-11-08T15:35:47Z | 116 | 11 | 168 | 0 | 37 | 0 | 44 | Schenkendorfstraße > Isarring > ? | Schwabing | München
2026-11-08T15:37:43Z | 2026-11-08T15:38:23Z | 50 | 5 | 317 | 273 | 13 | 0 | 41 | Petuelring > B 2R | Milbertshofen-Am Hart | München
2026-11-08T15:38:56Z | 2026-11-08T15:39:39Z | 53 | 3 | 13 | 0 | 4 | 0 | 30 | Lerchenauer Straße | Milbertshofen-Am Hart | München
2026-11-08T15:40:19Z | 2026-11-08T15:41:12Z | 63 | 4 | 36 | 0 | 8 | 0 | 26 | Lerchenauer Straße | Milbertshofen-Am Hart | München
2026-11-08T15:50:38Z | 2026-11-08T15:50:58Z | 30 | 3 | 24 | 0 | 7 | 1 | 0 | Lerchenauer Straße | Milbertshofen-Am Hart | München
2026-11-08T15:53:27Z | 2026-11-08T15:54:40Z | 83 | 8 | 100 | 1 | 19 | 0 | 27 | Lerchenauer Straße > Petuelring | Milbertshofen-Am Hart | München
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
