icepaule/Ice-Traffic-Data/ergebnisse/testfahrt-1/empfang_timeline.csv

utc | lat | lon | kmh | sats | pakete | cam_log | denm_log | spatem_log | mapem_log | signiert_log | sonstige_log | gespeichert_cam | gespeichert_denm | strasse | hausnummer | ortsteil | ort | plz
2026-11-08T15:26:50Z | 48.12221 | 11.62066 | 50 | 17 | 3 | 0 | 0 | 0 | 0 | 3 | 0 | 2 | 0 | Innsbrucker Ring |  | Berg am Laim | München | 81671
2026-11-08T15:27:01Z | 48.12322 | 11.62077 | 34 | 17 | 8 | 0 | 0 | 0 | 0 | 8 | 0 | 5 | 0 | Innsbrucker Ring |  | Berg am Laim | München | 81671
2026-11-08T15:27:13Z | 48.12363 | 11.62080 | 0 | 17 | 10 | 0 | 0 | 0 | 0 | 10 | 0 | 3 | 0 | Innsbrucker Ring |  | Berg am Laim | München | 81671
2026-11-08T15:27:23Z | 48.12363 | 11.62080 | 0 | 17 | 32 | 0 | 0 | 0 | 0 | 32 | 0 | 4 | 1 | Innsbrucker Ring |  | Berg am Laim | München | 81671
2026-11-08T15:27:33Z | 48.12379 | 11.62081 | 17 | 17 | 35 | 0 | 0 | 0 | 0 | 35 | 0 | 4 | 0 | Innsbrucker Ring |  | Berg am Laim | München | 81671
2026-11-08T15:27:43Z | 48.12457 | 11.62068 | 35 | 17 | 18 | 0 | 0 | 0 | 0 | 18 | 0 | 5 | 0 | Grafinger Straße |  | Berg am Laim | München | 81671
2026-11-08T15:32:28Z | 48.16009 | 11.60118 | 57 | 16 | 6 | 0 | 0 | 0 | 0 | 6 | 0 | 1 | 0 | Isarring |  | Schwabing | München | 80805
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
