icepaule/Ice-Traffic-Data/ergebnisse/testfahrt-1/daten/log_bereinigt.csv

utc | uptime_s | fix | lat | lon | kmh | sats | cam | denm | spatem | mapem | signiert | sonstige
2026-11-08T13:57:48Z | 93 | 0 | 0.000000 | 0.000000 | 0 | 0 | 0 | 0 | 0 | 0 | 0 | 0
2026-11-08T13:57:58Z | 103 | 0 | 0.000000 | 0.000000 | 0 | 0 | 0 | 0 | 0 | 0 | 0 | 0
2026-11-08T13:58:08Z | 113 | 0 | 0.000000 | 0.000000 | 0 | 0 | 0 | 0 | 0 | 0 | 0 | 0
2026-11-08T13:58:18Z | 123 | 0 | 0.000000 | 0.000000 | 0 | 0 | 0 | 0 | 0 | 0 | 0 | 0
2026-11-08T13:58:28Z | 133 | 0 | 0.000000 | 0.000000 | 0 | 0 | 0 | 0 | 0 | 0 | 0 | 0
2026-11-08T13:58:38Z | 143 | 0 | 0.000000 | 0.000000 | 0 | 0 | 0 | 0 | 0 | 0 | 0 | 0
2026-11-08T13:58:48Z | 153 | 0 | 0.000000 | 0.000000 | 0 | 0 | 0 | 0 | 0 | 0 | 0 | 0
2026-11-08T13:58:58Z | 163 | 0 | 0.000000 | 0.000000 | 0 | 0 | 0 | 0 | 0 | 0 | 0 | 0
2026-11-08T13:59:08Z | 173 | 0 | 0.000000 | 0.000000 | 0 | 0 | 0 | 0 | 0 | 0 | 0 | 0
2026-11-08T13:59:18Z | 183 | 0 | 0.000000 | 0.000000 | 0 | 0 | 0 | 0 | 0 | 0 | 0 | 0
2026-11-08T13:59:28Z | 193 | 0 | 0.000000 | 0.000000 | 0 | 0 | 0 | 0 | 0 | 0 | 0 | 0
2026-11-08T13:59:38Z | 203 | 0 | 0.000000 | 0.000000 | 0 | 0 | 0 | 0 | 0 | 0 | 0 | 0
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
