icepaule/Ice-Traffic-Data/(commit log)

2026-11-01 Decoder (CAM/DENM/SPATEM/MAPEM), Firmware-Patch DevKitM-1, Antennen- und LoRa-Analyse, Heimserver-Entwurf
2026-11-01 Oeffentlicher TLS-MQTT (its.mpauli.de), HA-Discovery, Bestellliste, LoRa-Auto-Knoten
2026-11-01 BOM der DigiKey-Bestellung (2x je Position) mit Teilebildern
2026-11-01 Dashboard unter its.mpauli.de veroeffentlicht (HAProxy, DE-only, Basic-Auth) nach Vorbild THW-Barbeleg
2026-11-01 LoRa-Auto-Knoten Firmware-Entwurf, ChirpStack-Provisionierung, LoRa->HA, Demo-Tool, Inbetriebnahme, TEMPUS-Recherche mit Mail-Entwurf
2026-11-01 LoRa-Knoten: IEEE-1609.2-Huelle auspacken, Typzaehlung auch fuer signierte Pakete (Testvektoren aus Decoder-Schema)
2026-11-01 Doku: 1609.2-Auspacken im LoRa-Knoten
2026-11-08 lora-car-node: eigenes WLAN mit Statusseite, lokaler Mitschnitt (log.csv, frames.bin im ITS5-Format)
2026-11-08 docs: Kapitel 18 (Schreibtischtest, Statusseite, Mitschnitt) mit Datenfluss, Verdrahtung, Ablauf und Screenshot; 16/17/README aktualisiert
2026-11-08 Gehaeuse v0.1: parametrisches CadQuery-Modell, STEP/STL, Renderings, Doku 19
    [IceTraffic_Gehaeuse_Deckel.step, IceTraffic_Gehaeuse_Deckel.stl, IceTraffic_Gehaeuse_Unterteil.step, IceTraffic_Gehaeuse_Unterteil.stl, IceTraffic_Montage_mit_Boards.step]
2026-11-08 Gehaeuse v0.2: Boardmasse aus Herstellerunterlagen (C3 38,9 x 25,4; XIAO-Stapel 21 x 17,8; C5 53,5 gemessen)
    [IceTraffic_Gehaeuse_Deckel.step, IceTraffic_Gehaeuse_Deckel.stl, IceTraffic_Gehaeuse_Unterteil.step, IceTraffic_Gehaeuse_Unterteil.stl, IceTraffic_Montage_mit_Boards.step]
2026-11-08 Gehaeuse: Passprobe (Clips, Prepboard-Schlitz, Bohrungen) als STEP/STL + Doku
    [IceTraffic_Gehaeuse_Deckel.step, IceTraffic_Gehaeuse_Unterteil.step, IceTraffic_Montage_mit_Boards.step, IceTraffic_Passprobe.step, IceTraffic_Passprobe.stl]
2026-11-08 Fix: GeoNetworking-Header-Typen korrekt (HT 5/HST 0 = SHB, 28 Byte), OER-Decode; Test mit echtem CAM der Testfahrt
    [its_parse.h]
2026-11-08 Ergebnisse Testfahrt 1: bereinigte Rohdaten, Empfangs-Timeline mit Adressen, Karte, Verbesserungsvorschläge mit Quellen
    [empfang_abschnitte.csv, empfang_timeline.csv, log_bereinigt.csv]
2026-11-08 Dashboard: POI-Karte (TEMPUS-Ampeln, Use Cases, A9) mit Google-Maps-Links, Autobahn-Baustellen live; Doku 23 TEMPUS-Nachfolge und Erweiterungen; Skripte
2026-11-09 V1: Schreibpfad ueberarbeitet (PSRAM-Puffer, Flash nur nach 3 s Funkstille in 4-kB-Haeppchen, Logzeilen im RAM, 64-kB-UART-Puffer, Blocklesen), Diagnosefelder; Testreihe dokumentiert
2026-11-09 build.sh: Patches 0001/0002 einzeln nach Stand von src/ anwenden; Doku: Portwahl und Pruefung per stats
    Ein aelteres, nur mit 0001 gepatchtes src/ wurde nicht auf 0002 gebracht (C5/C3 liefen unbemerkt ohne ITS6).
2026-11-09 C3-Bridge: Schleife leert UART-Puffer (Patch 0003), Test mit allen drei Geraeten dokumentiert
    Upstream-Schleife: 1 Paket je 50 ms -> bei 50 Paketen/s nur 87 von 200 angekommen; jetzt 200 von 200.
2026-11-09 Doku: Test MQTT-Weg und LoRa-Weg mit allen drei Geraeten; MQTT-Konfig geht beim C3-uploadfs verloren
2026-11-09 C3 meldet Sniffer-Zaehler/Feldstaerke per MQTT (0004), eigene Partitionstabelle (0005), LoRa-Nutzlast v2 (Funkstrecke), Decoder und Doku
2026-11-09 Doku 24: Messfahrt 2 Vorbereitung und Checkliste
2026-11-09 Gehaeuse v0.3: Prepboard-Schlitz entfaellt, C5/C3 nach innen, Strombuchse rechts, Passprobe C5-Ecke
    [IceTraffic_Gehaeuse_Deckel.step, IceTraffic_Gehaeuse_Deckel.stl, IceTraffic_Gehaeuse_Unterteil.step, IceTraffic_Gehaeuse_Unterteil.stl, IceTraffic_Montage_mit_Boards.step, IceTraffic_Passprobe.step, IceTraffic_Passprobe.stl, IceTraffic_Passprobe_C5_Ecke.step]
2026-11-09 Gehaeuse v0.3b: gemessene Gesamtlaengen C5 60/C3 45 mm (Antennenueberstand), GPS auf X=76
    [IceTraffic_Gehaeuse_Deckel.step, IceTraffic_Gehaeuse_Unterteil.step, IceTraffic_Gehaeuse_Unterteil.stl, IceTraffic_Montage_mit_Boards.step, IceTraffic_Passprobe.step, IceTraffic_Passprobe_C5_Ecke.step]
2026-11-09 Gehaeuse v0.3c: duennere konische Clipfedern, Boards an USB-Wand, Clips weg von Eckdomen
    [IceTraffic_Gehaeuse_Deckel.step, IceTraffic_Gehaeuse_Unterteil.step, IceTraffic_Gehaeuse_Unterteil.stl, IceTraffic_Montage_mit_Boards.step, IceTraffic_Passprobe.step, IceTraffic_Passprobe.stl, IceTraffic_Passprobe_C5_Ecke.step, IceTraffic_Passprobe_C5_Ecke.stl]
2026-11-09 Gehaeuse v0.3d: Platinenstege 1 mm hoeher (POST_H 6), USB-Schlitze unveraendert
    [IceTraffic_Gehaeuse_Deckel.step, IceTraffic_Gehaeuse_Unterteil.step, IceTraffic_Gehaeuse_Unterteil.stl, IceTraffic_Montage_mit_Boards.step, IceTraffic_Passprobe.step, IceTraffic_Passprobe.stl, IceTraffic_Passprobe_C5_Ecke.step, IceTraffic_Passprobe_C5_Ecke.stl]
2026-11-10 Dashboard: Auto-Knoten per LoRa (Beacon, Standort, Fahrtspur, gesendete/empfangene Daten)
